ITstreet1/WHITEBoard-Saola/PCB Files/Sheet_1.png

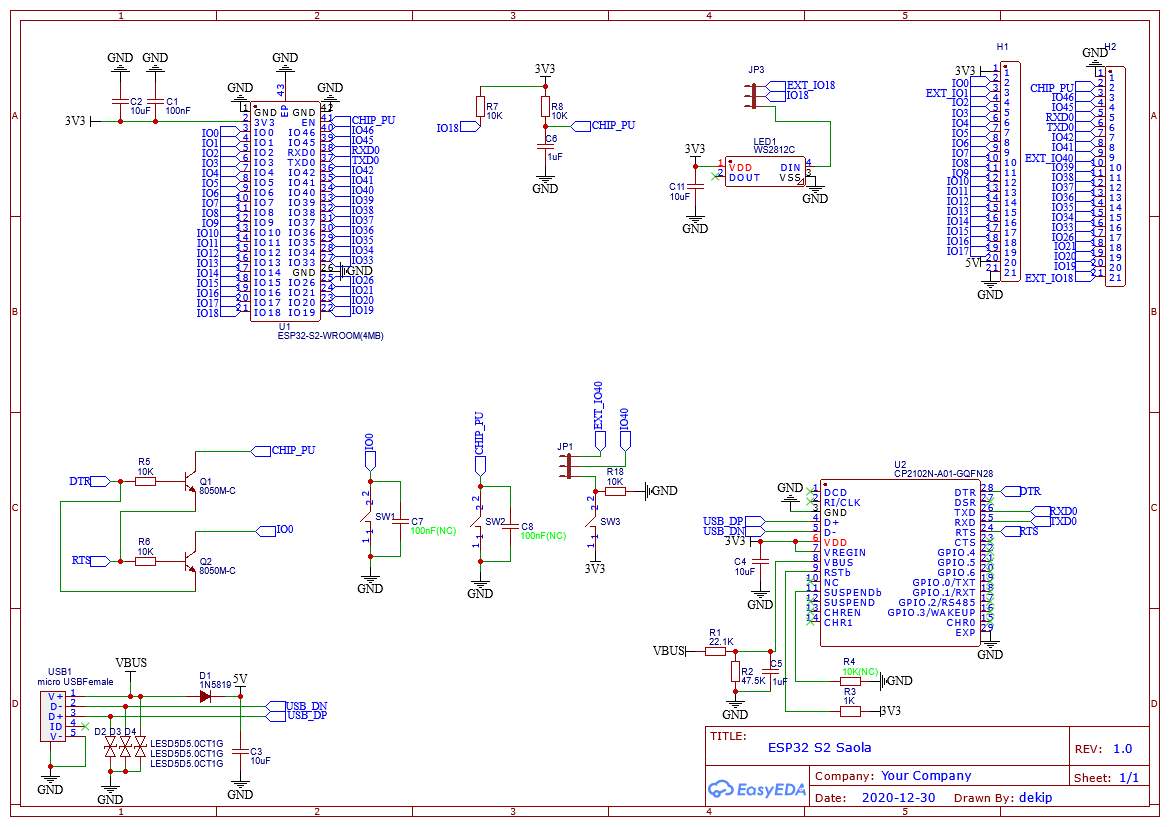
PCB Files/Sheet_1.png
