ITstreet1/WHITEBoard-Saola/PCB Files/Sheet_2.png

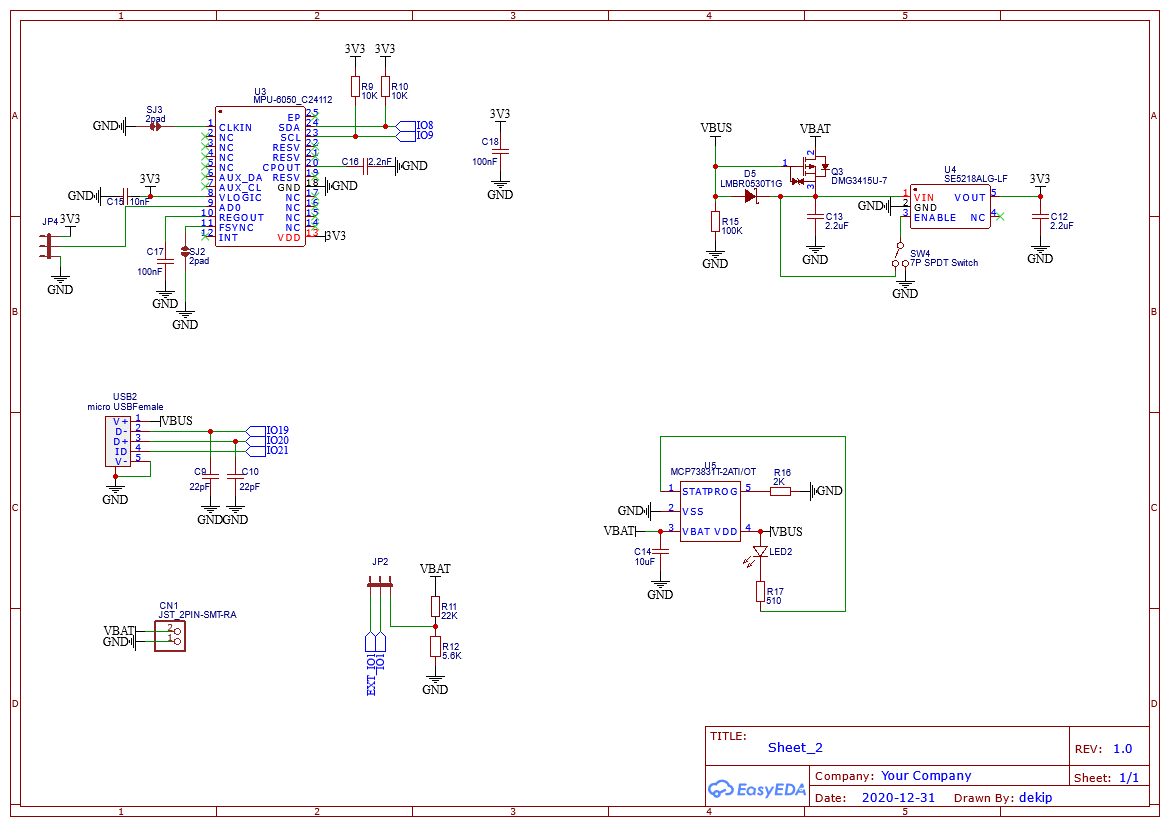
PCB Files/Sheet_2.png
