ITstreet1/WHITEBoard-Saola/(list of files, drawings)

Other design files:
PCB Files/SCH_WHITEBoard ESP32 S2 Saola_2021-06-30.json
