ITstreet1/WHITEBoard-Saola/Arduino IDE Examples/Button_State_change_detection_RGB.ino

/* Small modification of various examples
 * Author Dejan Petrovic
 * 7/17/2021
 * v1.0
 * RGB LED will turn green after fourth press of the button
*/
const int  buttonPin = 40;    // the pin that the pushbutton is attached to
#include <Adafruit_NeoPixel.h>
#define PIN 18   // the pin that the LED is attached to
Adafruit_NeoPixel strip = Adafruit_NeoPixel(1, PIN, NEO_GRB + NEO_KHZ800);     
// Variables will change:
int buttonPushCounter = 0;   // counter for the number of button presses
int buttonState = 0;         // current state of the button
int lastButtonState = 0;     // previous state of the button
void setup() {
  pinMode(buttonPin, INPUT);
  Serial.begin(9600);
  strip.begin();
  strip.setBrightness(50);
  strip.show(); // Initialize all pixels to 'off'
}
void loop() {
  // read the pushbutton input pin:
  buttonState = digitalRead(buttonPin);
  // compare the buttonState to its previous state
  if (buttonState != lastButtonState) {
    // if the state has changed, increment the counter
    if (buttonState == HIGH) {
      // if the current state is HIGH then the button went from off to on:
      buttonPushCounter++;
      Serial.println("on");
      Serial.print("number of button pushes: ");
      Serial.println(buttonPushCounter);
    } else {
      // if the current state is LOW then the button went from on to off:
      Serial.println("off");
    }
    // Delay a little bit to avoid bouncing
    delay(50);
  }
  // save the current state as the last state, for next time through the loop
  lastButtonState = buttonState;
  // turns on the LED every four button pushes by checking the modulo of the
  // button push counter. the modulo function gives you the remainder of the
  // division of two numbers:
  if (buttonPushCounter % 4 == 0) {
    colorWipe(strip.Color(0, 255, 0), 1000); // Green
  } else {
    colorWipe(strip.Color(0, 0, 0), 1000); // white
  }
}
// Fill the dots one after the other with a color
void colorWipe(uint32_t c, uint8_t wait) {
  for(uint16_t i=0; i<strip.numPixels(); i++) {
      strip.setPixelColor(i, c);
      strip.show();
      delay(wait);
  }
}
