ITstreet1/WHITEBoard-Saola/(commit log)

2021-07-17 Create Battery Voltage Measurement.inoe
2021-07-17 Rename Battery Voltage Measurement.inoe to Battery_Voltage_Measurement.ino
2021-08-09 Create CircuitPython Examples
